1998-felix/Coaxial-swirl-injector/images/assembly.png

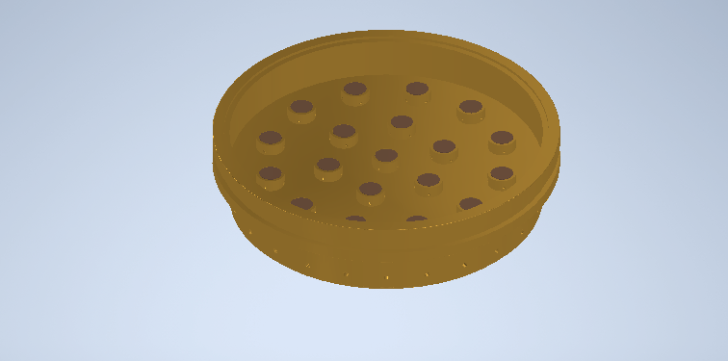
images/assembly.png
