1998-felix/Coaxial-swirl-injector/images/separator.png

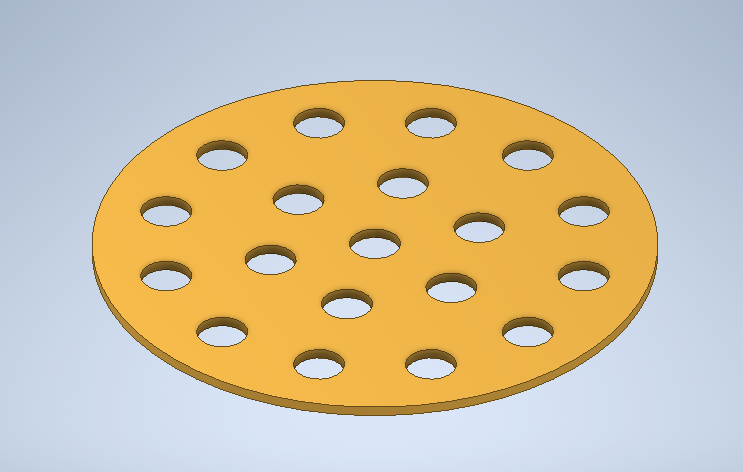
images/separator.png
