1998-felix/Coaxial-swirl-injector/README.md

# Coaxial-swirl-injector

The repository holds drawings and cam files for a coaxial swirl injector generated for classwork and for the nakuja project
