1998-felix/Coaxial-swirl-injector/images/Untitled.png

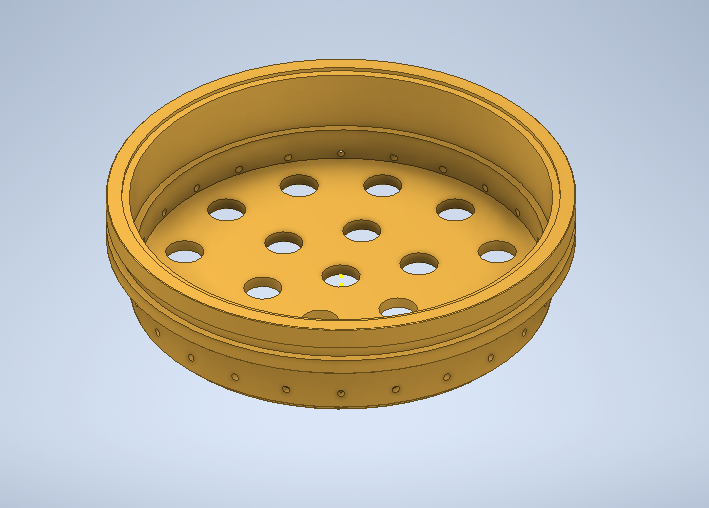
images/Untitled.png
