1998-felix/Coaxial-swirl-injector/(list of files, cad)

Other CAD files:
OldVersions/swirlerassembly.0001.dwg
OldVersions/base_single.0002.ipt
OldVersions/basev_1.0004.ipt
OldVersions/single-elemnt -assembly.0001.iam
Parts and assemblies/base_single.ipt
Parts and assemblies/basev_1.ipt
Parts and assemblies/cap.ipt
Parts and assemblies/injector assembly.iam
Parts and assemblies/inner element.ipt
Parts and assemblies/outer element.ipt
Parts and assemblies/separator.ipt
Parts and assemblies/separator_single.ipt
Parts and assemblies/separator_v2.ipt
Parts and assemblies/single-elemnt -assembly.iam
Parts and assemblies/swirlerassembly.iam
