1998-felix/Coaxial-swirl-injector/(commit log)

2021-07-25 Adding assembly
    [basev_1.0004.ipt, basev_1.ipt, cap.ipt, injector assembly.iam, inner element.ipt, outer element.ipt, separator_v2.0001.ipt, separator_v2.ipt]
2021-08-02 adding single element
    [base_single.0002.ipt, base_single.ipt, separator_single.ipt, single-elemnt -assembly.0001.iam, single-elemnt -assembly.iam]
2021-08-02 adding step
    [single-elemnt -assembly.stp]
2021-08-02 to print
2021-08-03 reorganizing repo
    [base_single.ipt, basev_1.ipt, cap.ipt, injector assembly.iam, inner element.ipt, outer element.ipt, separator.ipt, separator_single.ipt]
